gabrielturcot-netizen/gturcot-assets/le-coin-calme/moule-galets/apercu/couvercle_noyau.png

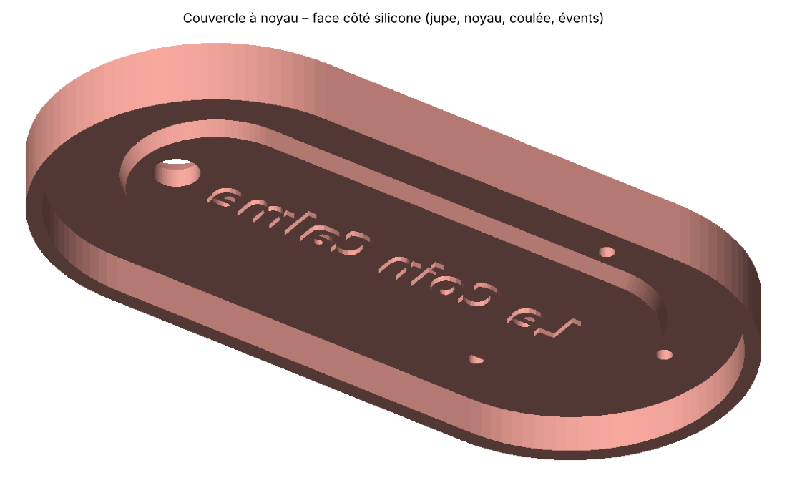
le-coin-calme/moule-galets/apercu/couvercle_noyau.png
