gabrielturcot-netizen/gturcot-assets/le-coin-calme/moule-galets/apercu/piece_reference.png

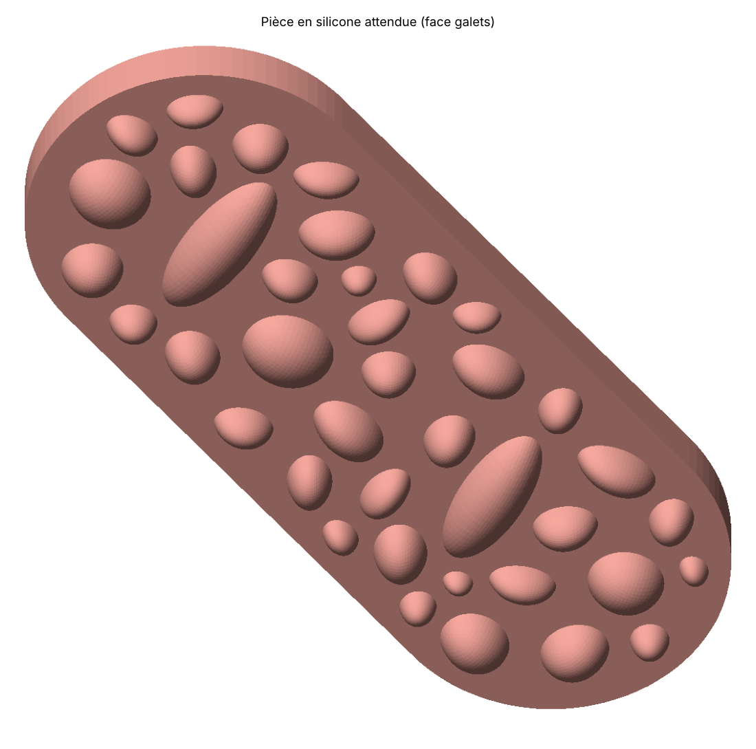
le-coin-calme/moule-galets/apercu/piece_reference.png
