gabrielturcot-netizen/gturcot-assets/signature_gturcot.png

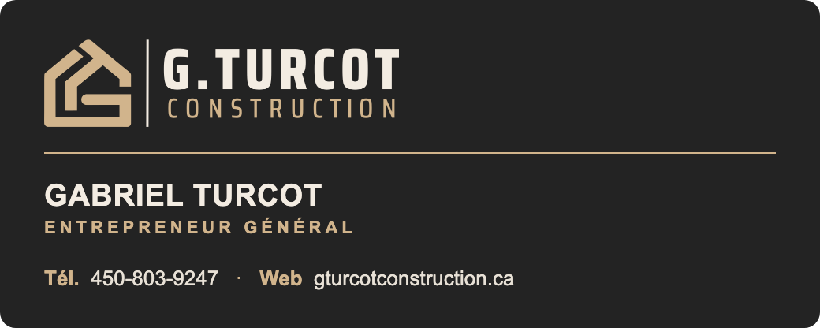
signature_gturcot.png
