gabrielturcot-netizen/gturcot-assets/signature_gturcot_h2.png

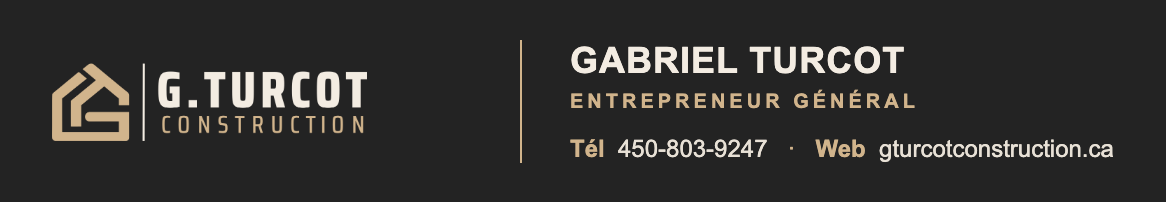
signature_gturcot_h2.png
