gabrielturcot-netizen/gturcot-assets/le-coin-calme/moule-galets/stl/moule_couvercle_plat.stl

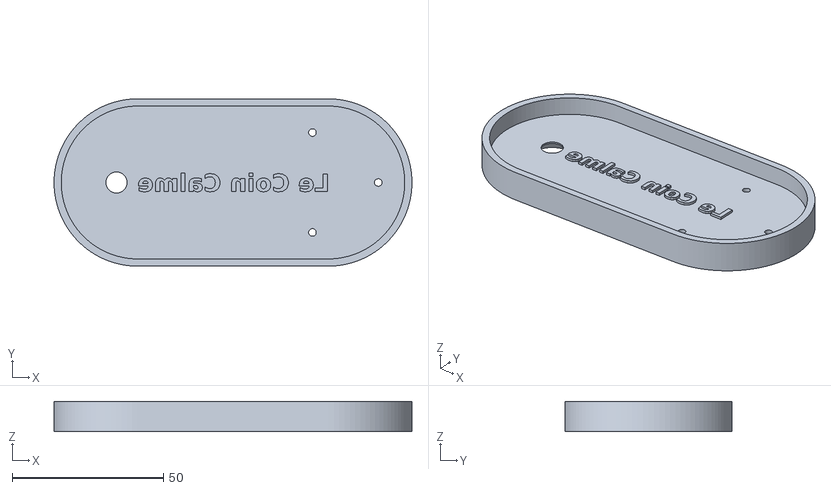
[picture p9: CAD file, 2026-11-09]
le-coin-calme/moule-galets/stl/moule_couvercle_plat.stl
118.3 x 55.3 x 9.98
