gabrielturcot-netizen/gturcot-assets/le-coin-calme/moule-galets/stl/moule_base.stl

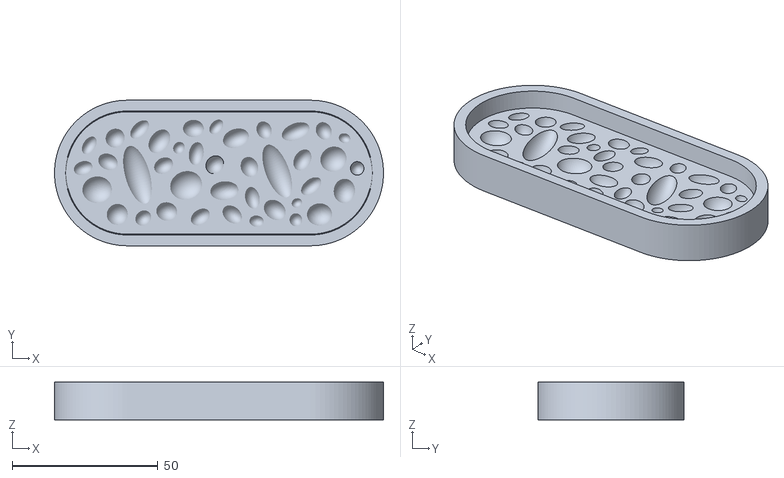
[picture p10: CAD file, 2026-11-09]
le-coin-calme/moule-galets/stl/moule_base.stl
113.0 x 50.0 x 13.0
