gabrielturcot-netizen/gturcot-assets/le-coin-calme/moule-galets/stl/piece_reference.stl

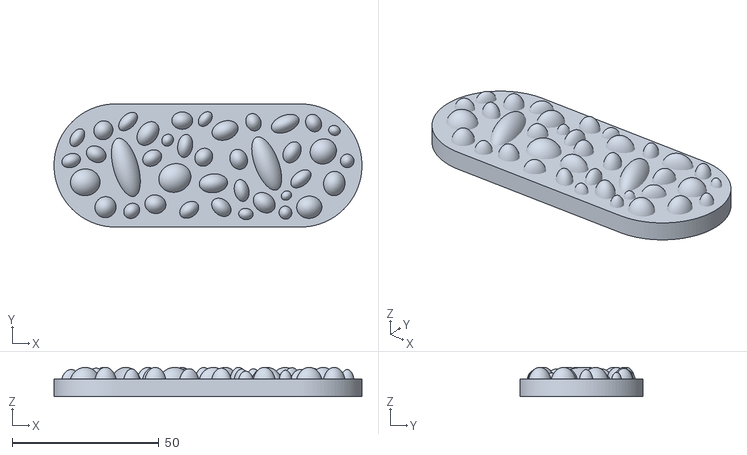
[picture p11: CAD file, 2026-11-09]
le-coin-calme/moule-galets/stl/piece_reference.stl
105.0 x 42.0 x 9.98
