gabrielturcot-netizen/gturcot-assets/(list of files, cad)

Other CAD files:
le-coin-calme/moule-galets/stl/moule_couvercle_noyau.stl
