gabrielturcot-netizen/gturcot-assets/(commit log)

2026-11-09 Ajout du moule paramétrique « galets » pour Le Coin Calme
    Générateur Python (manifold3d) du moule d'impression 3D pour le coussin
    tactile en silicone : moule base ouvert, couvercle plat à jupe et
    couvercle à noyau économique, pièce de référence, aperçus et guide de
    coulée. Plaque ramenée à 6 mm et dos évidable : 23 à 39 % de silicone en
    moins par pièce.
    Claude-Session: https://claude.ai/code/session_011REFt99iaqD8axTcnuYJys
2026-11-09 Marquage « Le Coin Calme » en miroir sur les couvercles du moule
    Lettres en relief (DejaVu Sans Bold, 0,8 mm) sur la face côté silicone
    des couvercles plat et à noyau, inversées pour être lisibles au dos de
    la pièce démoulée. Option de marquage sur la face galets du moule ouvert
    avec bande réservée sans galet. Guide mis à jour.
    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
